aarlaud/ConnectedHive/eagle/ConnectedHiveNode/node.brd

## EAGLE design eagle/ConnectedHiveNode/node.brd (2015-08-04)

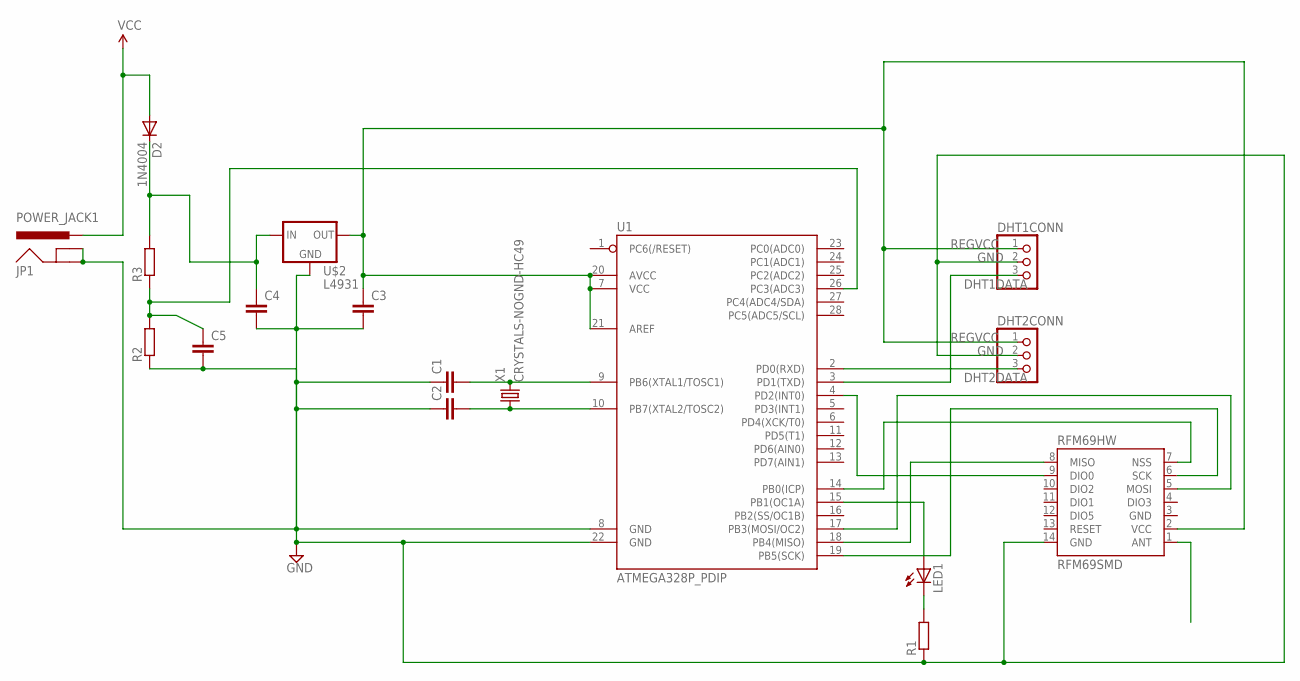
[picture p1: schematic node.sch, ConnectedHive Node Prototype version 1]

Parts:
C1, C2, C3, C4, C5: C-EU025-024X044; C025-024X044
D2: 1N4004; DO41-10
DHT1CONN, DHT2CONN: PINHD-1X3; 1X03
JP1: POWER_JACK1; POWER_JACK_SMD_OVERPASTE_REDBOARD_0603
LED1: LED3MM
R1, R2, R3: R-EU_0207/10; 0207/10
RFM69HW: RFM69SMD; RFM69
U1: ATMEGA328P_PDIP; DIL28-3
U$2: L4931; TO92
X1: CRYSTALS-NOGND-HC49; HC49

Connections:
DHT1DATA: DHT1CONN.3, U1.2 (PD0(RXD))
DHT2DATA: DHT2CONN.3, U1.3 (PD1(TXD))
GND: C1.1, C2.1, C3.2, C4.2, C5.2, DHT1CONN.2, DHT2CONN.2, JP1.GND (GNDBREAK), JP1.P$4 (GND), R1.1, R2.1, RFM69HW.3 (GND), RFM69HW.14 (GND), U1.8 (GND), U1.22 (GND), U$2.GND
unnamed: C1.2, U1.9 (PB6(XTAL1/TOSC1)), X1.2
unnamed: C2.2, U1.10 (PB7(XTAL2/TOSC2)), X1.1
unnamed: LED1.K (C), R1.2
unnamed: LED1.A, U1.15 (PB1(OC1A))
unnamed: C5.1, R2.2, R3.1, U1.26 (PC3(ADC3))
unnamed: RFM69HW.5 (MOSI), U1.17 (PB3(MOSI/OC2))
unnamed: RFM69HW.8 (MISO), U1.18 (PB4(MISO))
unnamed: RFM69HW.6 (SCK), U1.19 (PB5(SCK))
unnamed: RFM69HW.7 (NSS), U1.14 (PB0(ICP))
unnamed: RFM69HW.9 (DIO0), U1.4 (PD2(INT0))
REGVCC: C3.1, DHT1CONN.1, DHT2CONN.1, RFM69HW.2 (VCC), U1.7 (VCC), U1.20 (AVCC), U1.21 (AREF), U$2.OUT
RESET: RFM69HW.13 (RESET)
VCC: C4.1, D2.A, D2.C, JP1.VIN0 (PWR), R3.2, U$2.IN

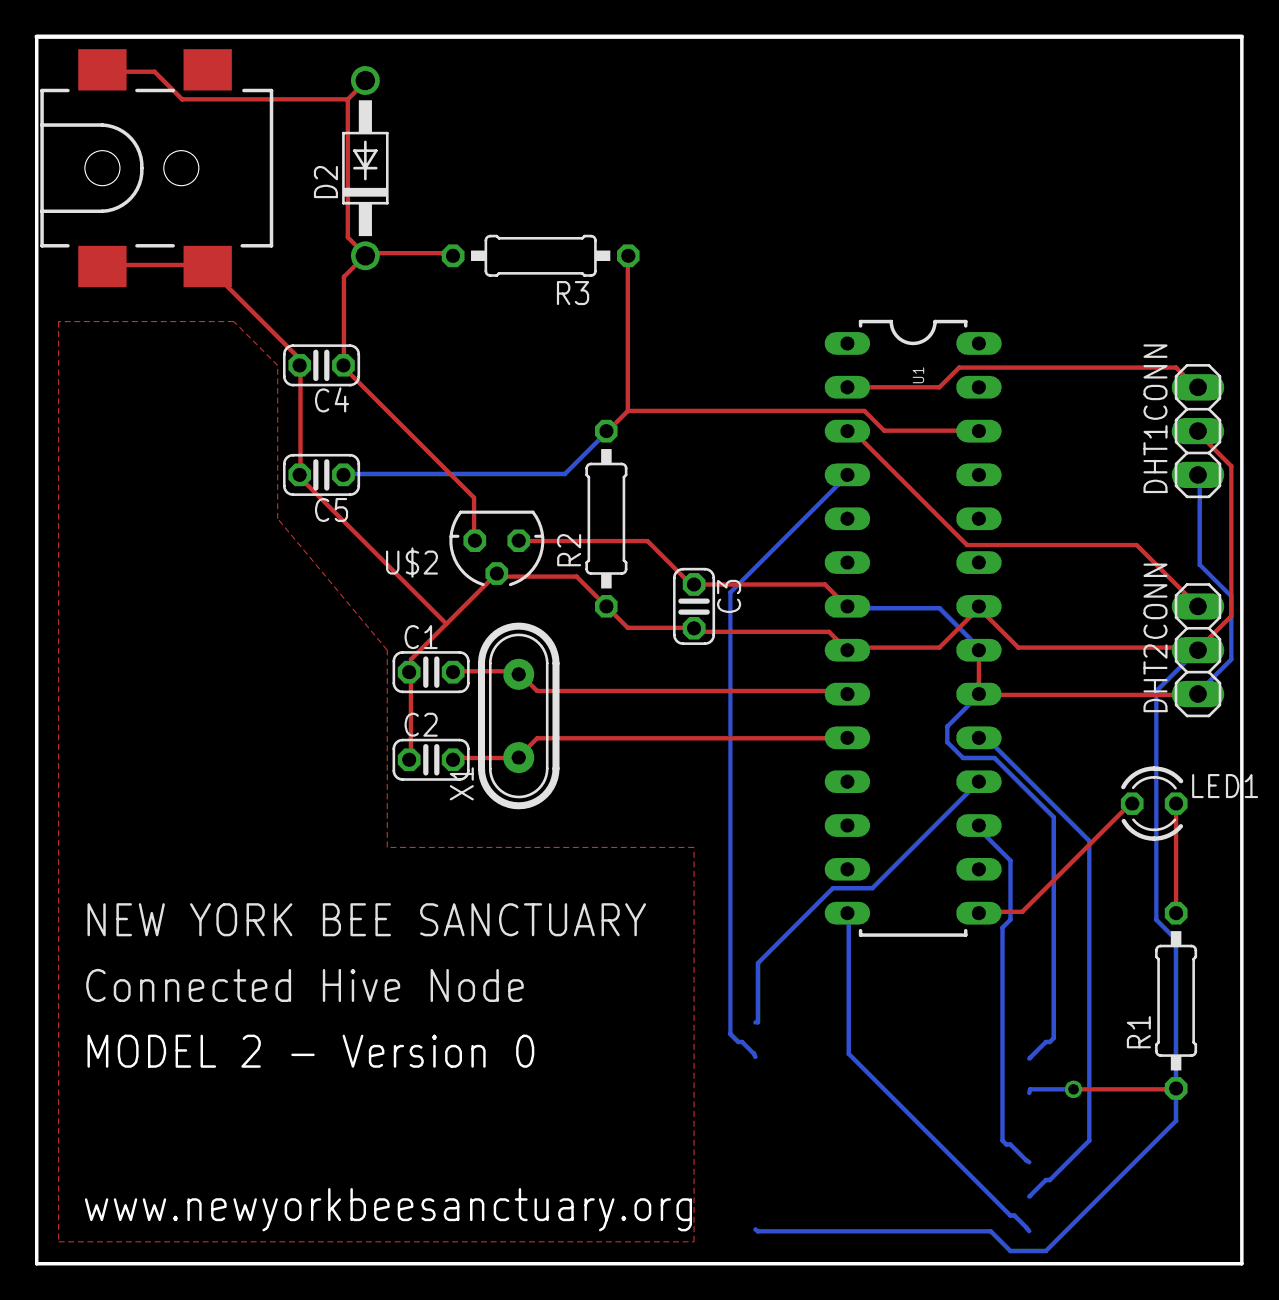
[picture p2: board node.brd from above]

Board: 2 copper layers, 69.8 x 71.1 mm, 17 parts (1 on the bottom side), 15 nets.
