aarlaud/ConnectedHive/(commit log)

2015-06-11 added inbound radio handling to receive ACK after sendingwithRetry requesting an ACK. Also added additional node config for multi sensors setup
2015-06-18 Added Radio LED indicator to troubleshoot radio hanging when Gateway get stuck on SendACK
    [Protov1_DHT22.ino, protov2_DHT22.ino]
2015-07-29 Added dht2 instantiation in proto2. Reduced/Removed all delays only to leave the few ms here and there for the ADC to do its part. Also put all pin to output and low to reduce power consumption
2015-07-31 Refactored DHT sensor readDHT function to read sensor directly. Will need a proper refactoring inside the library functions but good enough for prototyping and battery consumption tests. The adafruit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
2015-08-04 Adding Schematics and board for prototype version of Connected Hive Node Model 2 (2 DHT), version 0
    [node.brd, node.sch]
